Deng-ge-open-source/RL_SelfRisingRobot_StackForce/hardware/stl/README.md

# SelfRising 90S - 四件打印结构 / Four-part structure

本版本包含四个打印分件：底座、底盖、中间连杆、上部连杆。
以毫米为单位、100% 比例打印 01-04 号分件。整机参考仅用于查看装配位置，含四个结构件与两只舵机参考几何。

This version contains four printable parts: base, bottom cover, middle link and upper link.
Print parts 01-04 in millimetres at 100% scale. The assembled reference contains four structural parts and two servo reference geometries.

<table align="center">
<thead>
<tr>
<th align="center">编号 / No.</th>
<th align="center">零件 / Part</th>
<th align="center">文件 / File</th>
</tr>
</thead>
<tbody>
<tr>
<td align="center">1</td>
<td align="center">底座 / Base</td>
<td align="center"><a href="01-base.stl">01-base.stl</a></td>
</tr>
<tr>
<td align="center">2</td>
<td align="center">底盖 / Bottom cover</td>
<td align="center"><a href="02-bottom-cover.stl">02-bottom-cover.stl</a></td>
</tr>
<tr>
<td align="center">3</td>
<td align="center">中间连杆 / Middle link</td>
<td align="center"><a href="03-middle-link.stl">03-middle-link.stl</a></td>
</tr>
<tr>
<td align="center">4</td>
<td align="center">上部连杆 / Upper link</td>
<td align="center"><a href="04-upper-link.stl">04-upper-link.stl</a></td>
</tr>
</tbody>
</table>

打印设计采用 GPL-3.0-only，见 COPYING。外购舵机参考几何保留原有来源说明。
The modified printable designs use GPL-3.0-only; see COPYING. Purchased servo reference geometry retains its original provenance.

[查看整机装配参考 / Open assembled reference](SelfRising-90S-assembled.stl)
