Deng-ge-open-source/RL_SelfRisingRobot_StackForce/Sim-to-Sim/module/README.md

# 强化学习不倒翁 · 双轴自起立

This package was assembled locally from a server-signed StackForce ExportRecipe. Model and policy bytes were never uploaded to the export service.
