Deng-ge-open-source/RL_SelfRisingRobot_StackForce/Sim-to-Sim/docs/export_summary.md

# Export summary

- Project: 强化学习不倒翁 · 双轴自起立
- Source files: 9
- Root model: `selfrising-2axis/asset/model.xml`
- Assembly: browser-local from signed recipe
