Deng-ge-open-source/RL_SelfRisingRobot_StackForce/Sim-to-Sim/docs/known_limits.md

# Known limits

- Native keyboard input is event based: a direction remains active until another direction or the stop key is pressed.
- Sim2real hardware calibration and target I/O binding must be validated on the deployment machine.
