Deng-ge-open-source/RL_SelfRisingRobot_StackForce/Sim-to-Sim/README.md

# SelfRising · Sim-to-Sim 本地仿真

[返回首页](../README.md) · [English](#english)

本目录包含网站导出的模型、策略、配置和本地启动脚本，可直接在电脑上运行仿真。

- Windows：双击 `sim2sim/run_mujoco.cmd`。
- Linux：在本目录运行 `bash sim2sim/run_mujoco.sh`。
- 首次启动需要联网准备 Python 环境和依赖，后续复用环境。完整说明见 [启动文档](sim2sim/README.md)。

`module/`、`sim2sim/` 和 `manifest.json` 需要保持相对位置。内置策略与实物教程配套策略一致；它不是 [Training/](../Training/) 中新训练的九输入模型。已有验证范围见 [发布验证](../docs/release-validation.json)。

## English

This folder contains the website-exported model, policy, configuration and local launchers. On Windows, double-click `sim2sim/run_mujoco.cmd`. On Linux, run `bash sim2sim/run_mujoco.sh` from this folder. Internet access is needed for initial dependency setup. Keep the directory layout intact. See the [launcher instructions](sim2sim/README.md).

This runtime uses the supplied original-author policy matching the hardware example. It does not use the newly trained nine-input reference policy under [Training/](../Training/). See the repository's validation and provenance records.
