Deng-ge-open-source/RL_SelfRisingRobot_StackForce/docs/images/print-parts.png

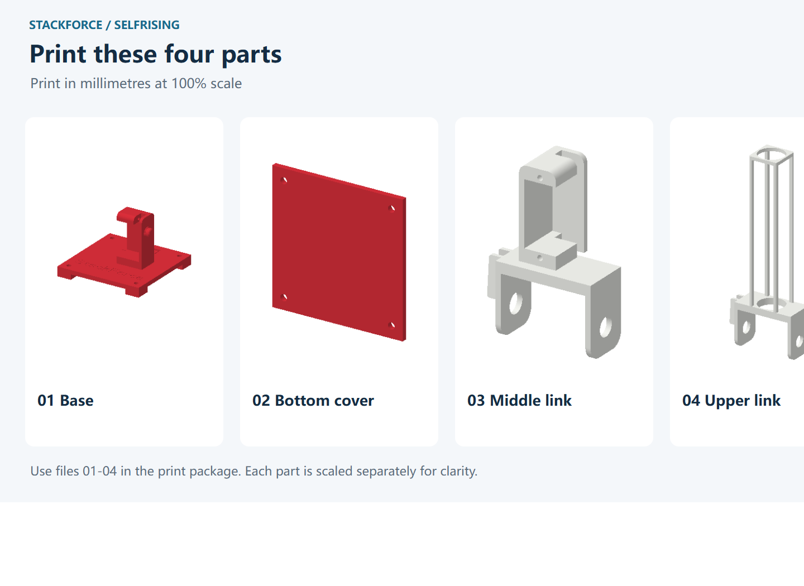
docs/images/print-parts.png
