Deng-ge-open-source/RL_SelfRisingRobot_StackForce/hardware/step/SelfRising-90S-assembled.stp

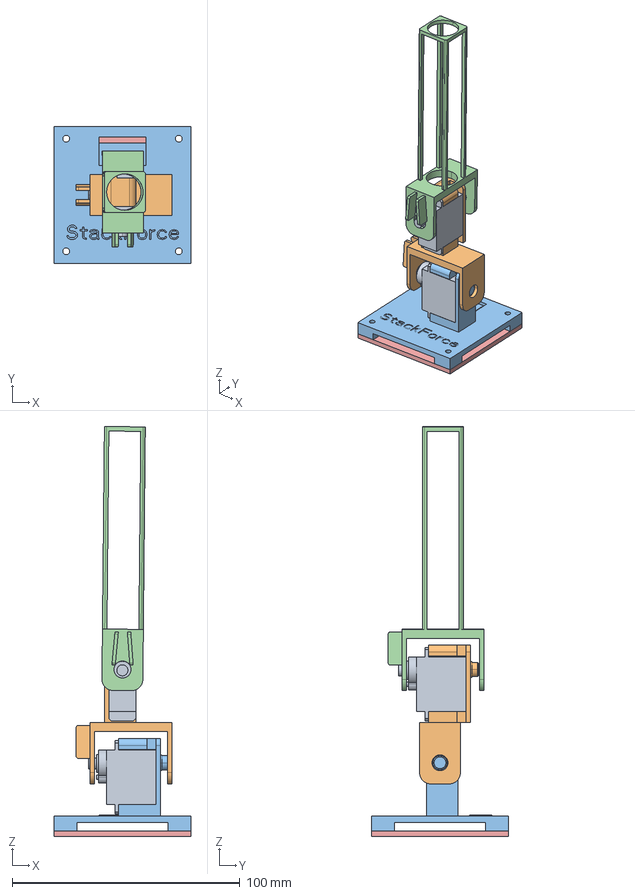
[picture p20: CAD file, 2026-11-10]
hardware/step/SelfRising-90S-assembled.stp
60.0 x 60.0 x 180.2 mm
