Deng-ge-open-source/RL_SelfRisingRobot_StackForce/Sim-to-Sim/module/asset/assets/meshes/ATOM.stl

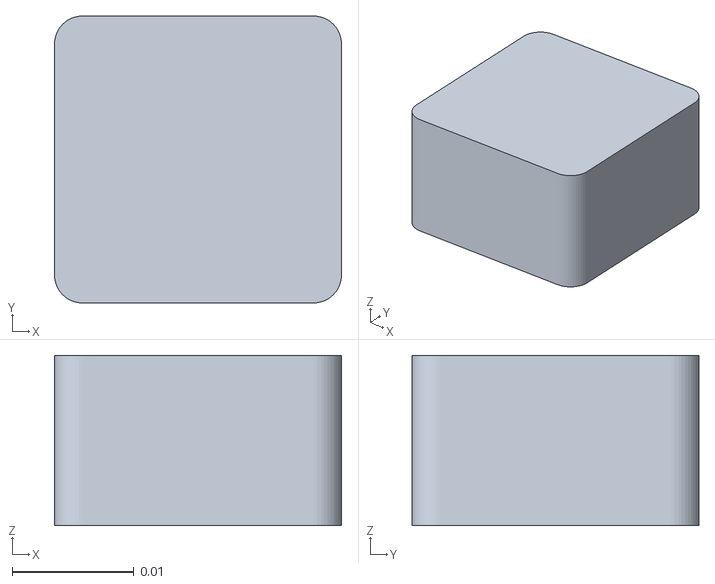
[picture p21: CAD file, 2026-11-10]
Sim-to-Sim/module/asset/assets/meshes/ATOM.stl
0.0236 x 0.0236 x 0.014
