Deng-ge-open-source/RL_SelfRisingRobot_StackForce/Training/src/stackforce_mjlab_self_rising_reference_v1/assets/assets/arm1.stl

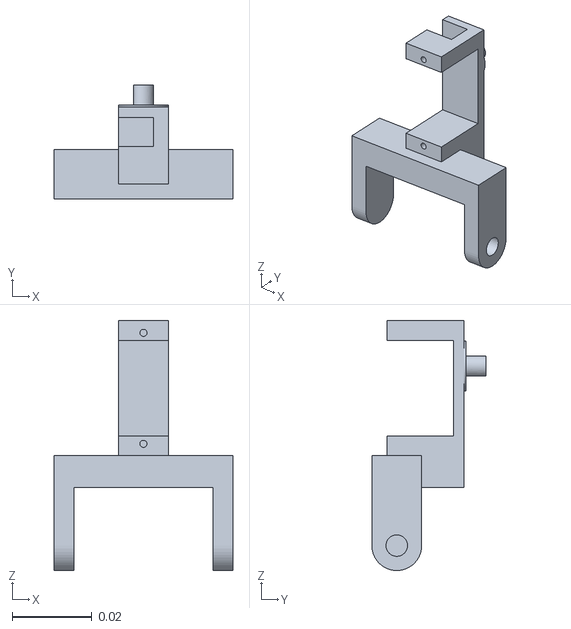
[picture p22: CAD file, 2026-11-10]
Training/src/stackforce_mjlab_self_rising_reference_v1/assets/assets/arm1.stl
0.0448 x 0.0287 x 0.0626
