Deng-ge-open-source/RL_SelfRisingRobot_StackForce/hardware/step/01-base.stp

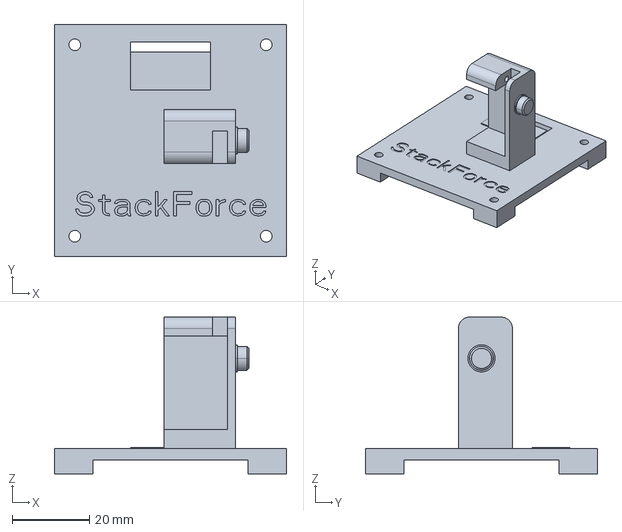
[picture p23: CAD file, 2026-11-09]
hardware/step/01-base.stp
60.0 x 60.0 x 40.6 mm
