Deng-ge-open-source/RL_SelfRisingRobot_StackForce/Sim-to-Sim/module/asset/assets/meshes/servo2.stl

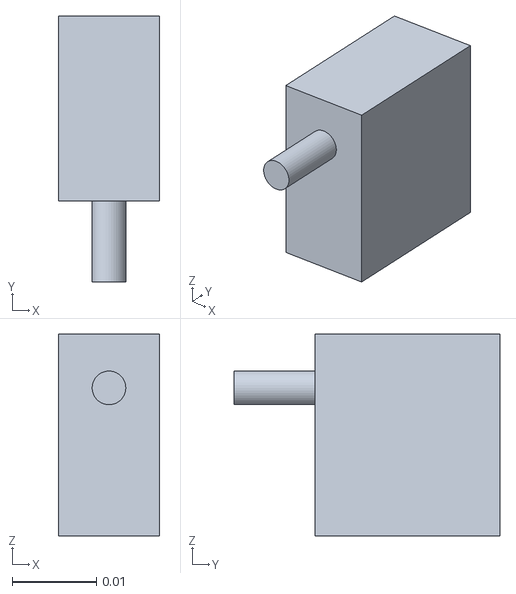
[picture p24: CAD file, 2026-11-10]
Sim-to-Sim/module/asset/assets/meshes/servo2.stl
0.012 x 0.0316 x 0.024
