Deng-ge-open-source/RL_SelfRisingRobot_StackForce/hardware/step/03-middle-link.stp

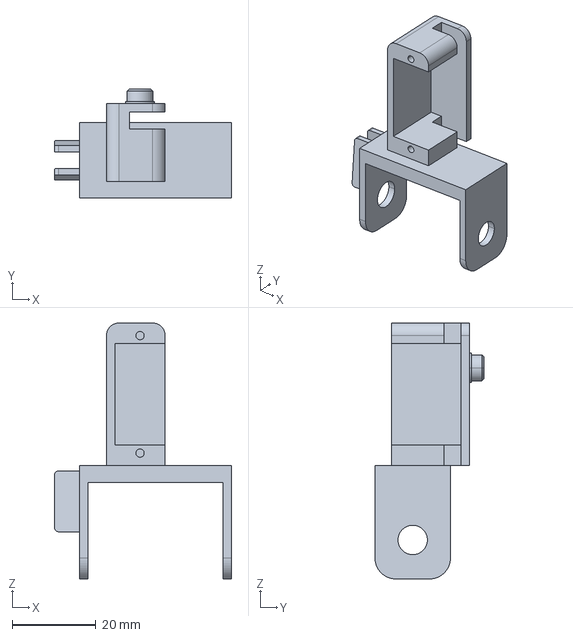
[picture p25: CAD file, 2026-11-09]
hardware/step/03-middle-link.stp
42.2 x 26.0 x 61.0 mm
