Deng-ge-open-source/RL_SelfRisingRobot_StackForce/Training/src/stackforce_mjlab_self_rising_reference_v1/assets/assets/arm2.stl

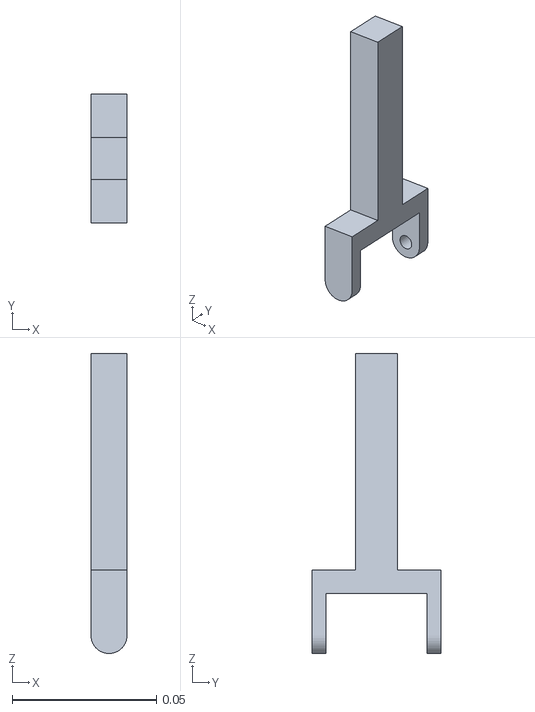
[picture p26: CAD file, 2026-11-10]
Training/src/stackforce_mjlab_self_rising_reference_v1/assets/assets/arm2.stl
0.0125 x 0.0448 x 0.104
