Deng-ge-open-source/RL_SelfRisingRobot_StackForce/hardware/step/02-bottom-cover.stp

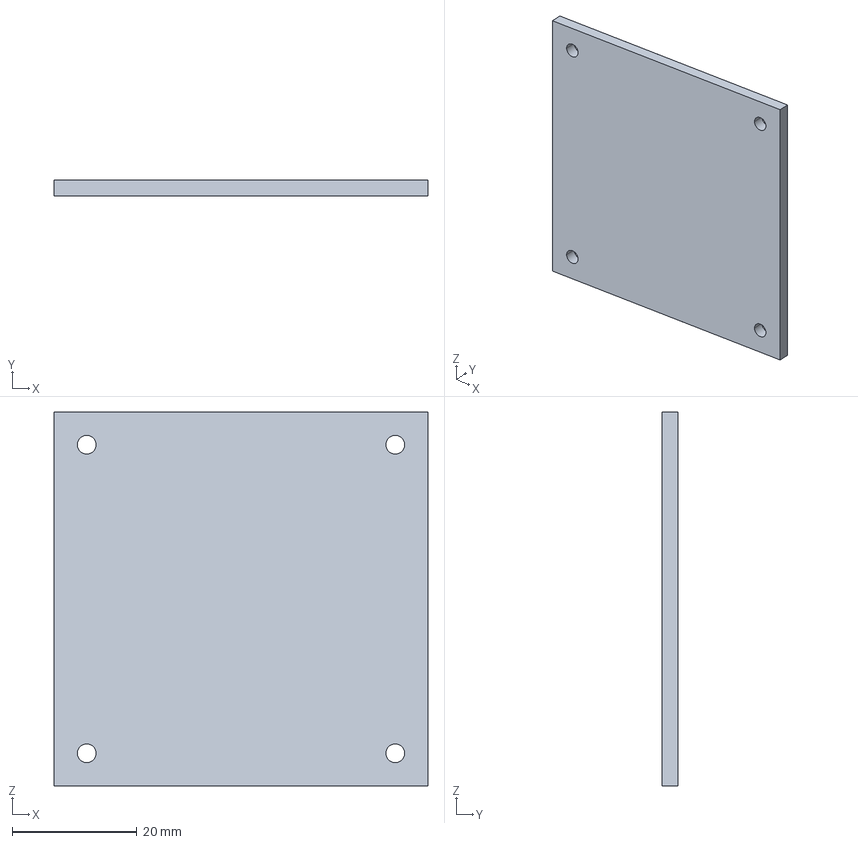
[picture p27: CAD file, 2026-11-09]
hardware/step/02-bottom-cover.stp
60.0 x 2.50 x 60.0 mm
