Deng-ge-open-source/RL_SelfRisingRobot_StackForce/hardware/step/04-upper-link.stp

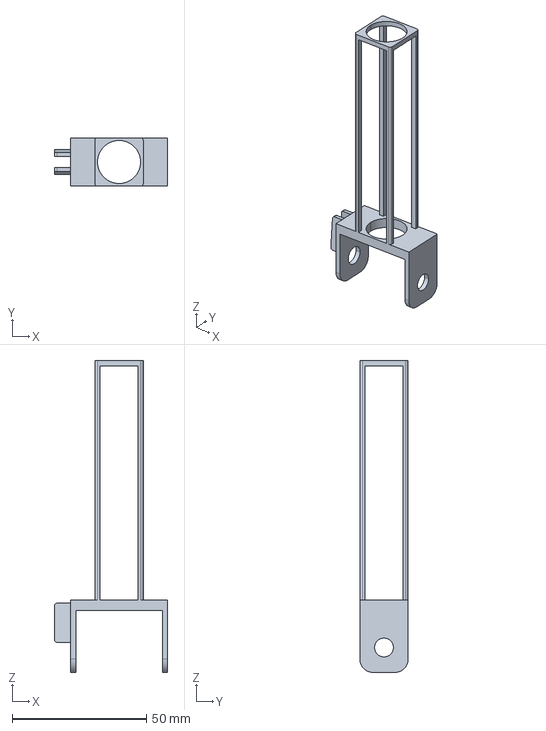
[picture p28: CAD file, 2026-11-09]
hardware/step/04-upper-link.stp
42.2 x 18.0 x 116.0 mm
