Deng-ge-open-source/RL_SelfRisingRobot_StackForce/Sim-to-Sim/module/asset/assets/meshes/foot.stl

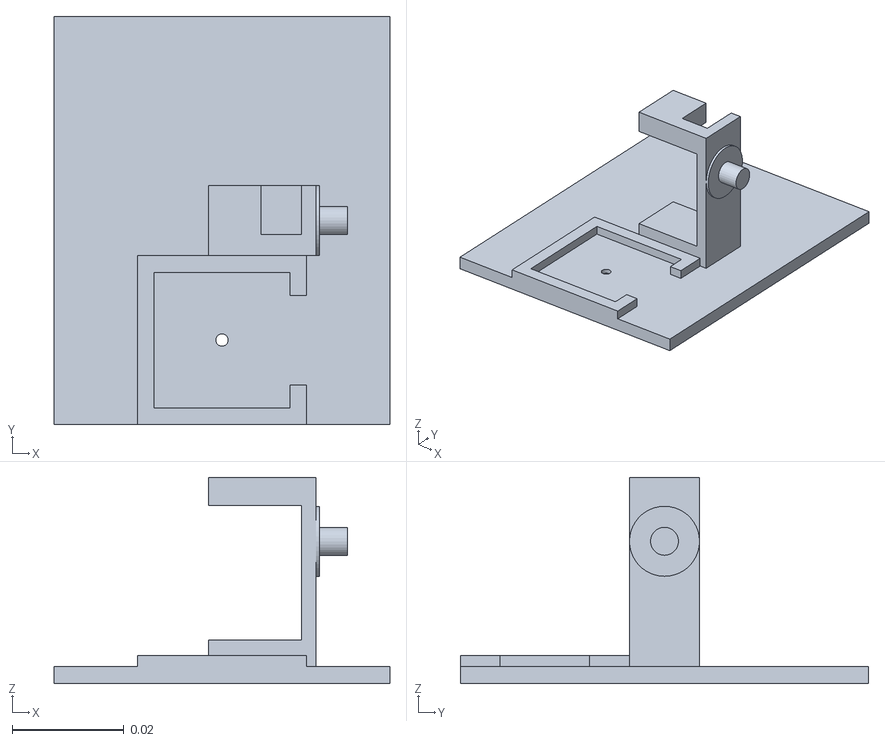
[picture p29: CAD file, 2026-11-10]
Sim-to-Sim/module/asset/assets/meshes/foot.stl
0.06 x 0.0729 x 0.0368
