Deng-ge-open-source/RL_SelfRisingRobot_StackForce/(list of files, cad)

Other CAD files:
Training/src/stackforce_mjlab_self_rising_reference_v1/assets/assets/servo1.stl
Sim-to-Sim/module/asset/assets/meshes/servo1.stl
hardware/stl/01-base.stl
hardware/stl/02-bottom-cover.stl
hardware/stl/03-middle-link.stl
hardware/stl/04-upper-link.stl
hardware/stl/SelfRising-90S-assembled.stl
