Deng-ge-open-source/RL_SelfRisingRobot_StackForce/docs/images/selfrising-assembled.png

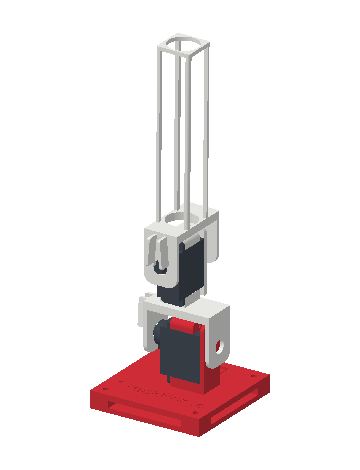
docs/images/selfrising-assembled.png
