Deng-ge-open-source/RL_SelfRisingRobot_StackForce/Sim-to-Sim/module/tests/README.md

Use this package as an importer/exporter regression fixture before adding hardware tests.
