Deng-ge-open-source/RL_SelfRisingRobot_StackForce/(commit log)

2026-11-09 Publish SelfRising build guide and print files
    [01-base.stl, 02-bottom-cover.stl, 03-middle-link.stl, 04-upper-link.stl, 05-spacer-ring.stl, SelfRising-90S-assembled.stl]
2026-11-09 Publish SelfRising review kit with binary firmware and bilingual guides
    [01-base.stp, 02-bottom-cover.stp, 03-middle-link.stp, 04-upper-link.stp, 05-spacer-ring.stp, SelfRising-90S-assembled.stp]
2026-11-10 Publish four-part SelfRising guide with fully English figures
    [05-spacer-ring.stl, 05-spacer-ring.stp, SelfRising-90S-assembled.stl, SelfRising-90S-assembled.stp]
2026-11-10 Publish replay animations and exported SelfRising projects
    [ATOM.stl, arm1.stl, arm2.stl, foot.stl, servo1.stl, servo2.stl]
2026-11-10 Organize root simulation and training folders and remove duplicate archives
    [ATOM.stl, arm1.stl, arm2.stl, foot.stl, servo1.stl, servo2.stl]
